ZacharyLincoln/HorizontalHydroponics/stl/Cap v5.stl

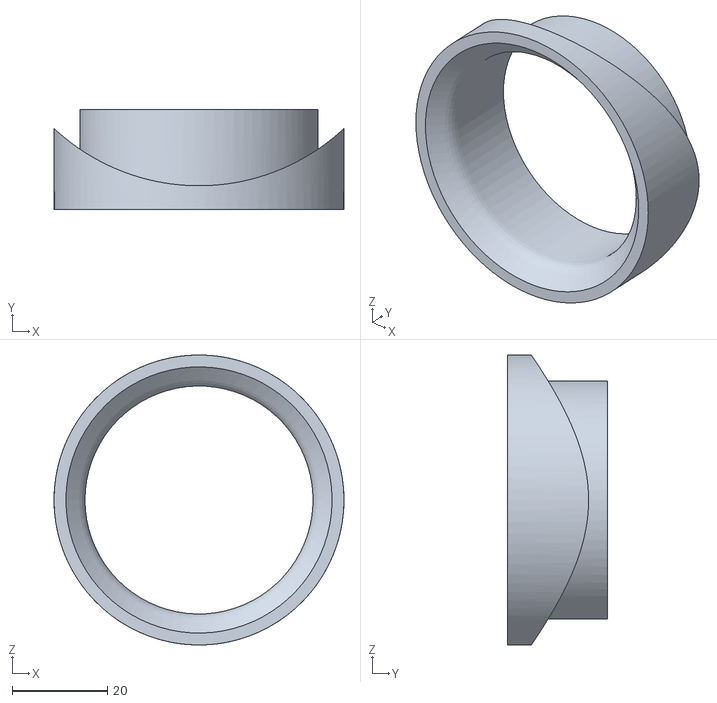
[picture p10: CAD file, 2022-07-10]
stl/Cap v5.stl
60.8 x 21.0 x 60.8
