ZacharyLincoln/HorizontalHydroponics/stl/Pipe Holder v8.stl

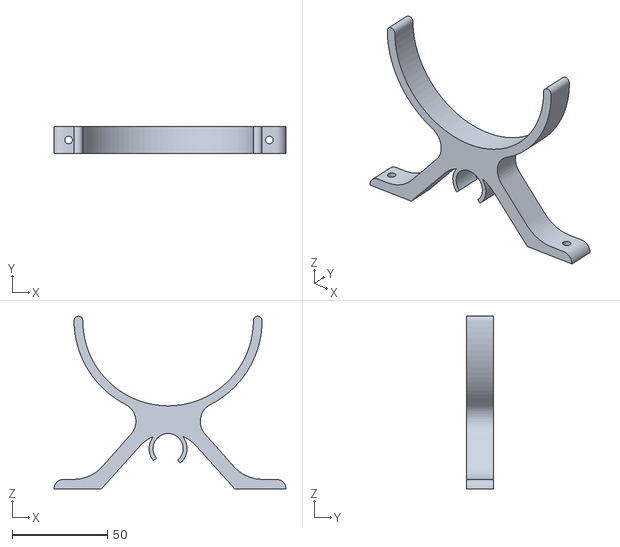
[picture p11: CAD file, 2022-07-10]
stl/Pipe Holder v8.stl
122.0 x 14.0 x 90.8
