ZacharyLincoln/HorizontalHydroponics/(commit log)

2022-07-10 Added all files that weren't pushed in initial commit.
    [Cap v5.stl, Pipe Holder v8.stl]
2022-07-10 Added: Prices for the materials Licence
    Fixed: Page navigation
